donfroula/toneplant/Assembled_Prototype.JPG

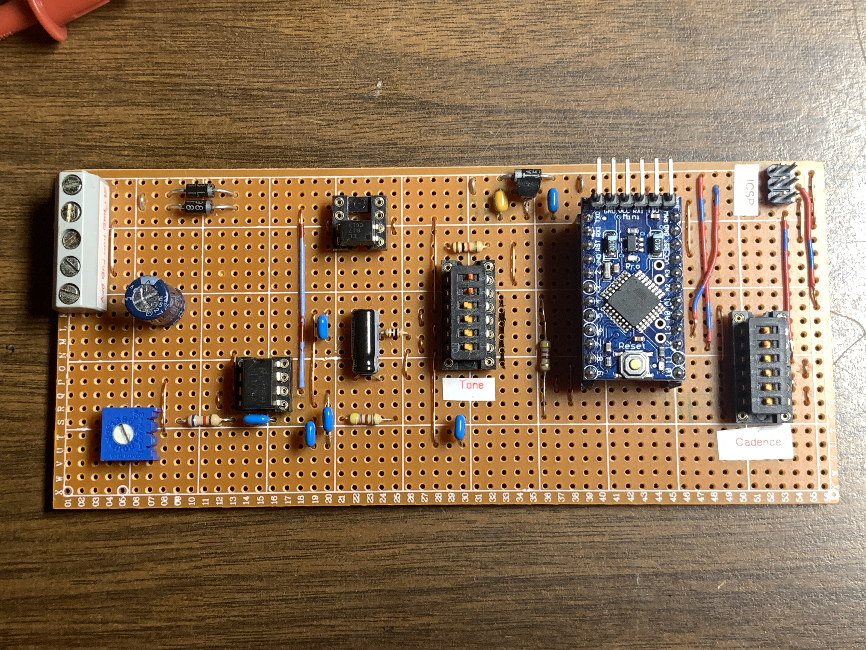
Assembled_Prototype.JPG
