donfroula/toneplant/simplest.jpg

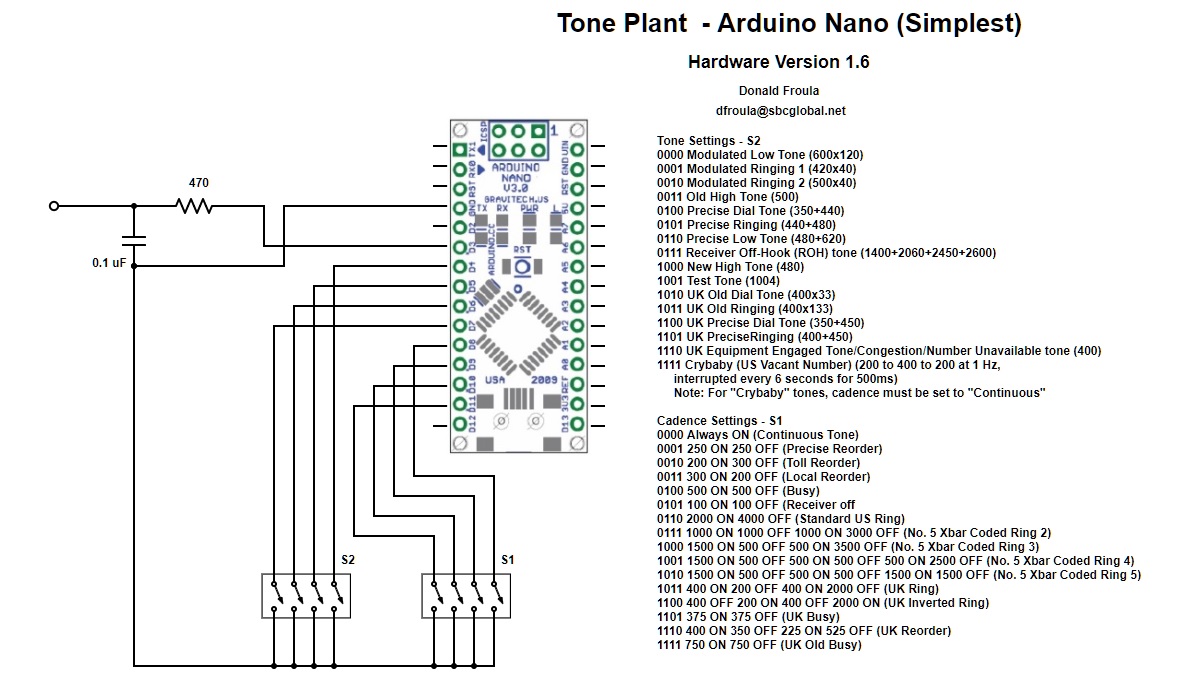
simplest.jpg
