donfroula/toneplant/toneplant_schematic_atmega328p_1_6.jpg

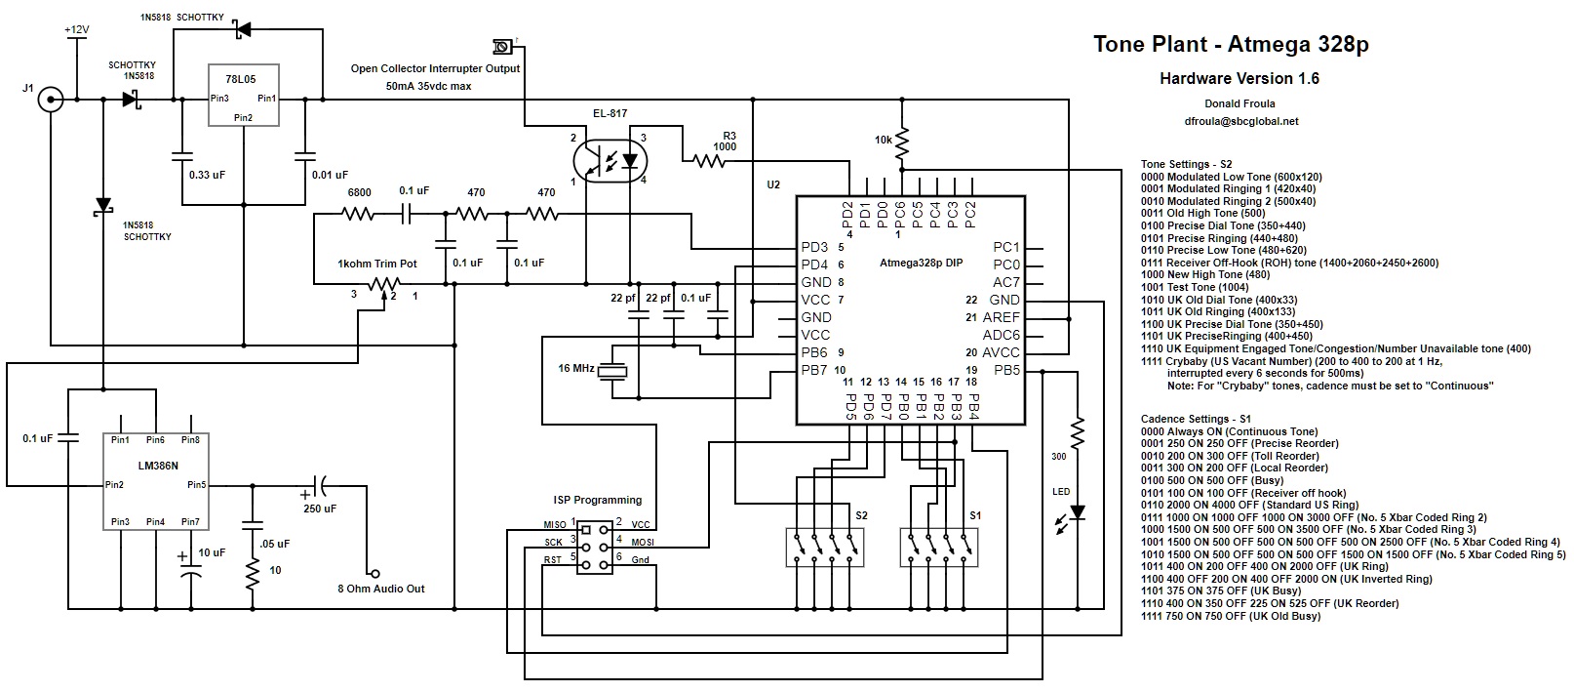
toneplant_schematic_atmega328p_1_6.jpg
