donfroula/toneplant/toneplant_schematic_nano_1_6.jpg

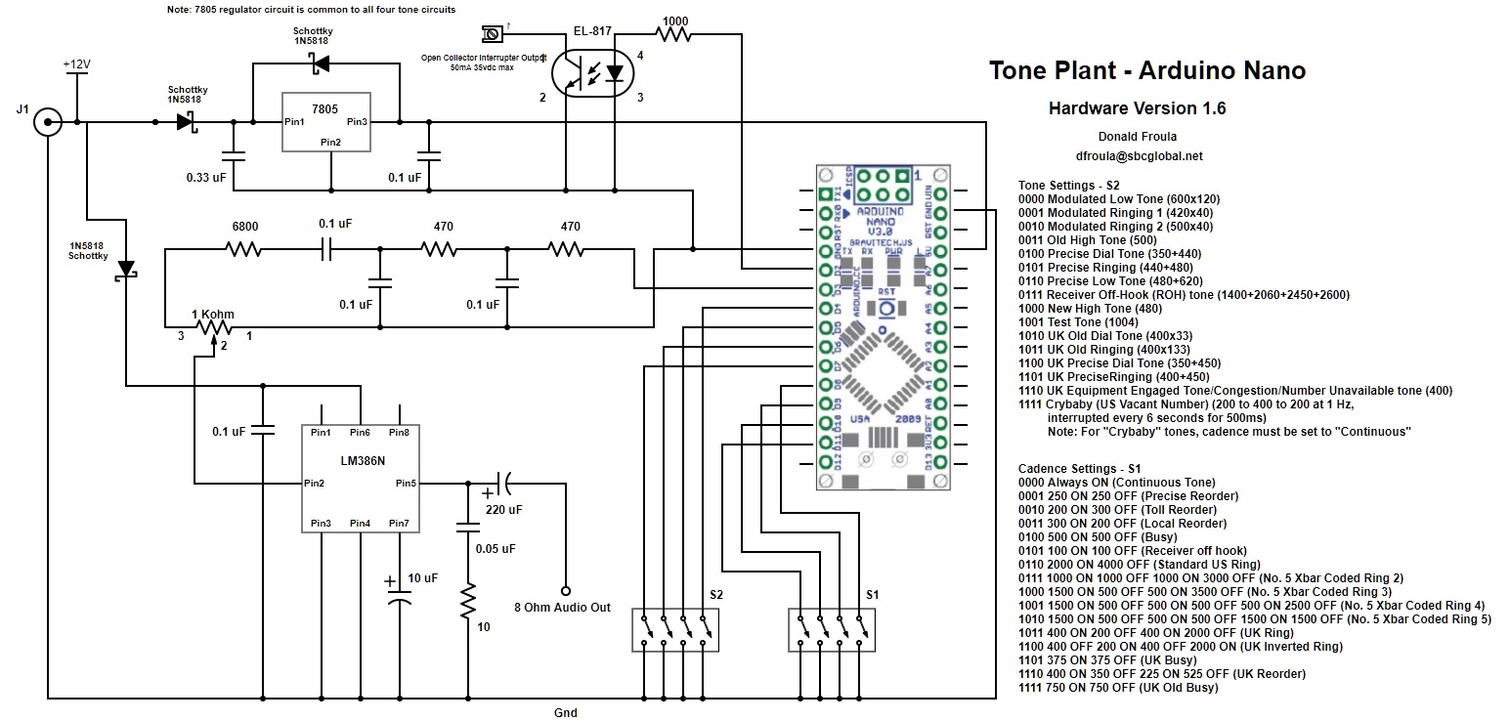
toneplant_schematic_nano_1_6.jpg
