donfroula/toneplant/toneplant_schematic_pro_mini_1_6.jpg

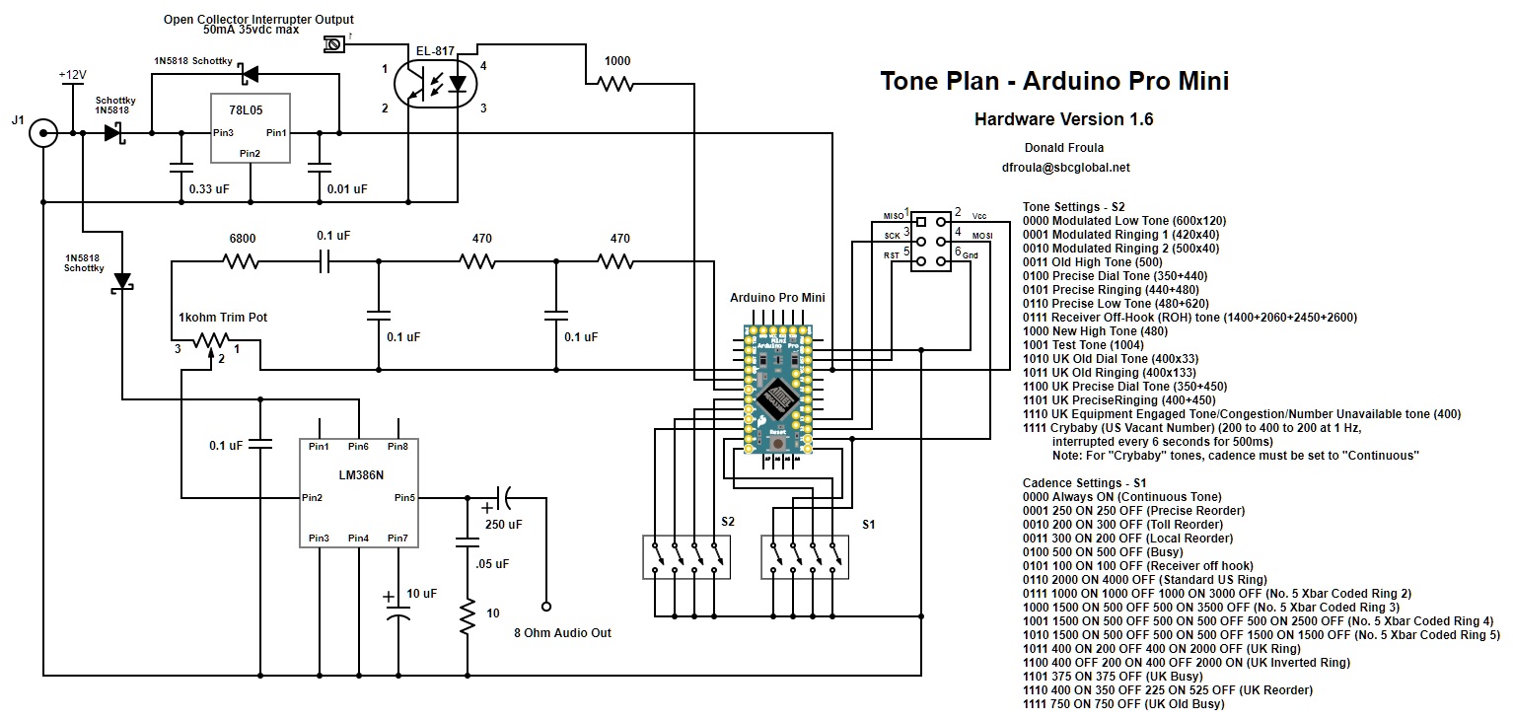
toneplant_schematic_pro_mini_1_6.jpg
