donfroula/toneplant/toneplant328/tables.h

//  Tables V2

#ifndef _TABLES
#define _TABLES

const PROGMEM char SinTable[]=
{
	0,	//0
	3,	//1
	6,	//2
	9,	//3
	12,	//4
	15,	//5
	18,	//6
	21,	//7
	24,	//8
	27,	//9
	30,	//10
	33,	//11
	36,	//12
	39,	//13
	42,	//14
	45,	//15
	48,	//16
	51,	//17
	54,	//18
	57,	//19
	59,	//20
	62,	//21
	65,	//22
	67,	//23
	70,	//24
	73,	//25
	75,	//26
	78,	//27
	80,	//28
	82,	//29
	85,	//30
	87,	//31
	89,	//32
	91,	//33
	94,	//34
	96,	//35
	98,	//36
	100,	//37
	102,	//38
	103,	//39
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
};

const PROGMEM char  SquareTable[]=
{
  127,  //0
  127,  //1
  127,  //2
  127,  //3
  127,  //4
  127,  //5
  127,  //6
  127,  //7
  127,  //8
  127,  //9
  127,  //10
  127,  //11
  127,  //12
  127,  //13
  127,  //14
  127,  //15
  127,  //16
  127,  //17
  127,  //18
  127,  //19
  127,  //20
  127,  //21
  127,  //22
  127,  //23
  127,  //24
  127,  //25
  127,  //26
  127,  //27
  127,  //28
  127,  //29
  127,  //30
  127,  //31
  127,  //32
  127,  //33
  127,  //34
  127,  //35
  127,  //36
  127,  //37
  127,  //38
  127,  //39
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
};


const PROGMEM char RampTable[]=
{
  -127, //0
  -126, //1
  -125, //2
  -124, //3
  -123, //4
  -122, //5
  -121, //6
  -120, //7
  -119, //8
  -118, //9
  -117, //10
  -116, //11
  -115, //12
  -114, //13
  -113, //14
  -112, //15
  -111, //16
  -110, //17
  -109, //18
  -108, //19
  -107, //20
  -106, //21
  -105, //22
  -104, //23
  -103, //24
  -102, //25
  -101, //26
  -100, //27
  -99,  //28
  -98,  //29
  -97,  //30
  -96,  //31
  -95,  //32
  -94,  //33
  -93,  //34
  -92,  //35
  -91,  //36
  -90,  //37
  -89,  //38
  -88,  //39
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
};


//Exponential steps for Crybaby tone increase/decrease to mimic capacitor discharge/charge


const PROGMEM float discharge_sequence[]={
200,201,203,204,206,207,209,210,212,213,
214,216,218,219,221,222,224,225,227,228,
230,232,233,235,237,238,240,242,243,245,
247,248,250,252,254,256,257,259,261,263,
265,266,268,270,272,274,276,278,280,282,
284,286,288,290,292,294,296,298,300,302,
304,307,309,311,313,315,317,320,322,324,
326,329,331,333,336,338,340,343,345,348,
350,353,355,358,360,363,365,368,370,373,
376,378,381,383,386,389,392,394,397,400
};

const PROGMEM float charge_sequence[]={
400,399,398,396,395,394,392,391,390,388,
387,385,384,382,381,379,378,376,375,373,
372,370,368,367,365,363,362,360,358,356,
355,353,351,349,347,346,344,342,340,338,
336,334,332,330,328,326,324,322,320,318,
316,314,312,310,308,306,304,301,299,297,
295,293,290,288,286,284,281,279,277,274,
272,270,267,265,263,260,258,256,253,251,
248,246,243,241,238,236,233,231,228,226,
223,221,218,216,213,210,208,205,203,200
};

#endif
