donfroula/toneplant/(commit log)

2019-08-11 Added Arduino source code and tonegen library
    Added Arduino source code and tonegen library. Pu all files within the same directory. There is no need to install the tonegen library if this is done.
    This code will only run on Atmega328p-based Arduinos. With minor changes to the timer structure, it may also be run on 32u4-based boards. Future releases will include conditional compilation to support thode Arduino types.
    Either the precompiled hex code may be used with avrdude to program an Arduino or bare ATMEGA328p chip, or the source code may be loaded into the Arduino IDE directly and compiled and loaded into the Arduino via conventional means.
2021-05-24 Add files via upload
    Photo of a completed prototype board.
2022-02-01 Add sample audio wav file
    Contains sample of all tones at representative cadences in the following order:
    US Precise Dial Tone - Continuous
    Modulated Low Tone (Old US dial tone, 600Hz x 120Hz) - Continuous
    UK Precise Dial Tone - Continuous
    UK Old "Power" Dial Tone (400Hz x 33Hz) - Continuous
    Precise US Ringing - 2000ms ON 4000ms OFF (Standard US Ring)
    Modulated US Ringing 1 (400Hz x 40Hz) - 2000ms ON 4000ms OFF (Standard US Ring)
    Modulated US Ringing 2 (500Hz x 40Hz) - 2000ms ON 4000ms OFF (Standard US Ring)
    Modulated US Ringing 1 (400Hz x 40Hz) - 1000ms ON 1000ms OFF 1000ms ON 3000ms OFF (No. 5 Xbar Coded Ring 2)
    Modulated US Ringing 1 (400Hz x 40Hz) - 1500ms ON 500ms OFF 500ms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
2022-02-01 Add files via upload
    Modulated US Ringing 1 (400Hz x 40Hz) - 1500ms ON 500ms OFF 500ms ON 35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
